guodinglang/C4-1/(list of files, drawings)

Other design files:
PCB/SCH&PCB_C4-1(42X21)/DAC_PART.SchDoc
PCB/SCH&PCB_C4-1(42X21)/DC_BOOST_PART.SchDoc
PCB/SCH&PCB_C4-1(42X21)/MCU_PART.SchDoc
PCB/SCH&PCB_C4-1(42X21)/PCB1.PcbDoc
PCB/SCH&PCB_C4-1(42X21)/PCB_Project1.PrjPCB
PCB/SCH&PCB_C4-1(42X21)/POWER_PART.SchDoc
