guodinglang/C4-1/Project/bsp/src/at32f415_int.c

/**
  **************************************************************************
  * @file     at32f415_int.c
  * @version  v2.0.5
  * @date     2022-05-20
  * @brief    main interrupt service routines.
  **************************************************************************
  *                       Copyright notice & Disclaimer
  *
  * The software Board Support Package (BSP) that is made available to
  * download from Artery official website is the copyrighted work of Artery.
  * Artery authorizes customers to use, copy, and distribute the BSP
  * software and its related documentation for the purpose of design and
  * development in conjunction with Artery microcontrollers. Use of the
  * software is governed by this copyright notice and the following disclaimer.
  *
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
  **************************************************************************
  */

/* includes ------------------------------------------------------------------*/
#include "projectCommon.h"
#include "at32f415_int.h"

/** @addtogroup AT32F415_periph_template
  * @{
  */

/** @addtogroup 415_LED_toggle
  * @{
  */

/**
  * @brief  this function handles nmi exception.
  * @param  none
  * @retval none
  */
void NMI_Handler(void)
{
}

/**
  * @brief  this function handles hard fault exception.
  * @param  none
  * @retval none
  */
void HardFault_Handler(void)
{
  /* go to infinite loop when hard fault exception occurs */
  while(1)
  {
  }
}

/**
  * @brief  this function handles memory manage exception.
  * @param  none
  * @retval none
  */
void MemManage_Handler(void)
{
  /* go to infinite loop when memory manage exception occurs */
  while(1)
  {
	  ALR_LED(1);
	  ALARM(1);
  }
}

/**
  * @brief  this function handles bus fault exception.
  * @param  none
  * @retval none
  */
void BusFault_Handler(void)
{
  /* go to infinite loop when bus fault exception occurs */
  while(1)
  {
	  ALR_LED(1);
	  ALARM(1);
  }
}

/**
  * @brief  this function handles usage fault exception.
  * @param  none
  * @retval none
  */
void UsageFault_Handler(void)
{
  /* go to infinite loop when usage fault exception occurs */
  while(1)
  {
	  ALR_LED(1);
	  ALARM(1);
  }
}

/**
  * @brief  this function handles svcall exception.
  * @param  none
  * @retval none
  */
void SVC_Handler(void)
{
}

/**
  * @brief  this function handles debug monitor exception.
  * @param  none
  * @retval none
  */
void DebugMon_Handler(void)
{
}

/**
  * @brief  this function handles pendsv_handler exception.
  * @param  none
  * @retval none
  */
void PendSV_Handler(void)
{
}

/**
  * @brief  this function handles systick handler.
  * @param  none
  * @retval none
  */
void SysTick_Handler(void)
{
	if(pUART->TimeOut>0)
	{pUART->TimeOut--;}
	
//	GPIOD->odt ^= GPIO_PINS_1;
}


/**
  * @brief  exint8 interrupt handler
  * @param  none
  * @retval none
  */
void EXINT9_5_IRQHandler(void)
{
	if(exint_flag_get(EXINT_LINE_8) != RESET)
	{
		if(!STROBE && swMess.parallel == false)
		{
			if(!STROBE)
			{
				swMess.buff = gpio_input_data_read(GPIOB);	
				if(swMess.buff == gpio_input_data_read(GPIOB))
				{
					swMess.parallel =true;
					BUSY(1);
				}
			}
		}
		exint_flag_clear(EXINT_LINE_8);
	}
}

/**
  * @brief  exint15 interrupt handler
  * @param  none
  * @retval none
  */
void EXINT15_10_IRQHandler(void)
{

}

/**
  * @brief  this function handles usart2 handler.
  * @param  none
  * @retval none
  */
void USART1_IRQHandler(void)
{
	uint8_t s;
	if(usart_flag_get(USART1, USART_RDBF_FLAG) != RESET)
	{
		s = USART1->dt;
		pUART->TimeOut=10;	//1ms*x
		
		if((s=='\r')||(s=='\n'))
        {pUART->rxn++;}
		else if(pUART->len < RX_MAX_FIFO)
		{pUART->rxFIFO[pUART->len++]=s;}	  
		
		usart_flag_clear(USART1, USART_RDBF_FLAG);
	}
}


/**
  * @}
  */

/**
  * @}
  */
