guodinglang/C4-1/Project/bsp/inc/projectCommon.h

/*
*********************************************************************************************************
*	                                  
*	模块名称 : include
*	文件名称 : PulicIncludes
*	版    本 : V1.0
*	说    明 : 总的头文件。
*	修改记录 :
*     版本号     日期       作者      说明
*     
*		
*      BLOG: http://blog.sina.com.cn/u/2565749395
*********************************************************************************************************
*/
#ifndef __PROJECT_COMMON_H__
#define __PROJECT_COMMON_H__

#ifdef __cplusplus
 extern "C" {
#endif


#include <stdio.h>
#include <stdint.h>
#include <stdarg.h>
#include <stdbool.h>
#include <string.h>
#include <stdlib.h>
#include <math.h>

//--------------------------------------------------
#include "at32f415.h"
#include "at32f415_clock.h"
//#include "ExternalAD.h"
//#include "SimulateIIC.h"
#include "Initial.h"
#include "IOstream.h"
#include "SerialPort.h"
#include "Command.h"
#include "flash.h"
#include "SPIdrive.h"
#include "Function.h"  
#include "AD5504.h"
#include "chokeDelay.h"
//#include "InteriorAD.h"
//#include "Buzzer.h"


//--------------------------------------------------
  


#endif  	 
