guodinglang/C4-1/(commit log)

2026-07-24 初始化项目，第一次提交
2026-07-24 上传PCB文件
    [DAC_PART.SchDoc, DC_BOOST_PART.SchDoc, MCU_PART.SchDoc, PCB1.PcbDoc, PCB_Project1.PrjPCB, POWER_PART.SchDoc]
2026-07-24 上传项目文档
    [DAC_PART.SchDoc, DC_BOOST_PART.SchDoc, MCU_PART.SchDoc, PCB1.PcbDoc, PCB_Project1.PrjPCB, POWER_PART.SchDoc]
2026-07-24 添加MDK编译文件gitignore过滤，屏蔽编译产物
2026-07-24 过滤Keil uvguix界面缓存文件
2026-07-24 上传测试数据和介绍文档
    [校准表.xlsx, 测试数据.xlsx]
